openenergymonitor/emonTH/hardware/Datasheets/Evatron PP42M case drawing.jpg

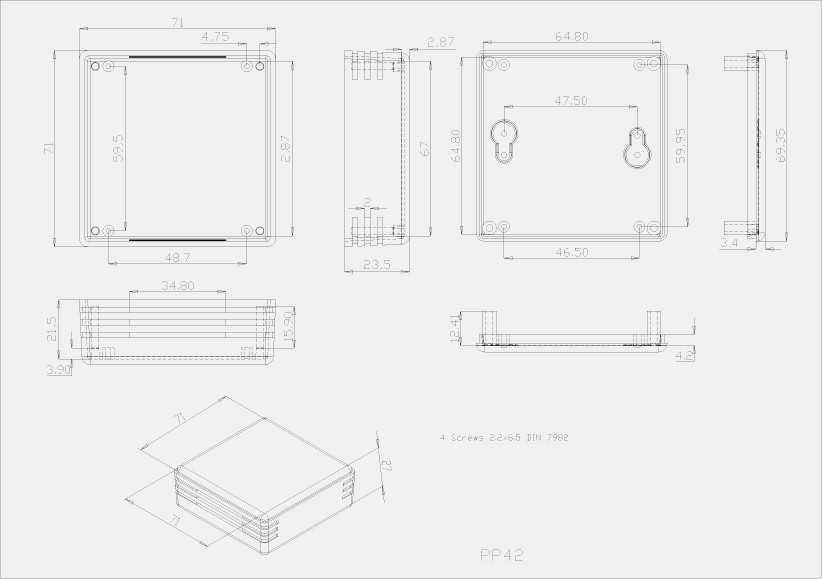
hardware/Datasheets/Evatron PP42M case drawing.jpg
