openenergymonitor/emonTH/hardware/emonTH_V1_4/emonTH V1.4.brd

## EAGLE design hardware/emonTH_V1_4/emonTH V1.4.brd (2017-03-15, an earlier design)

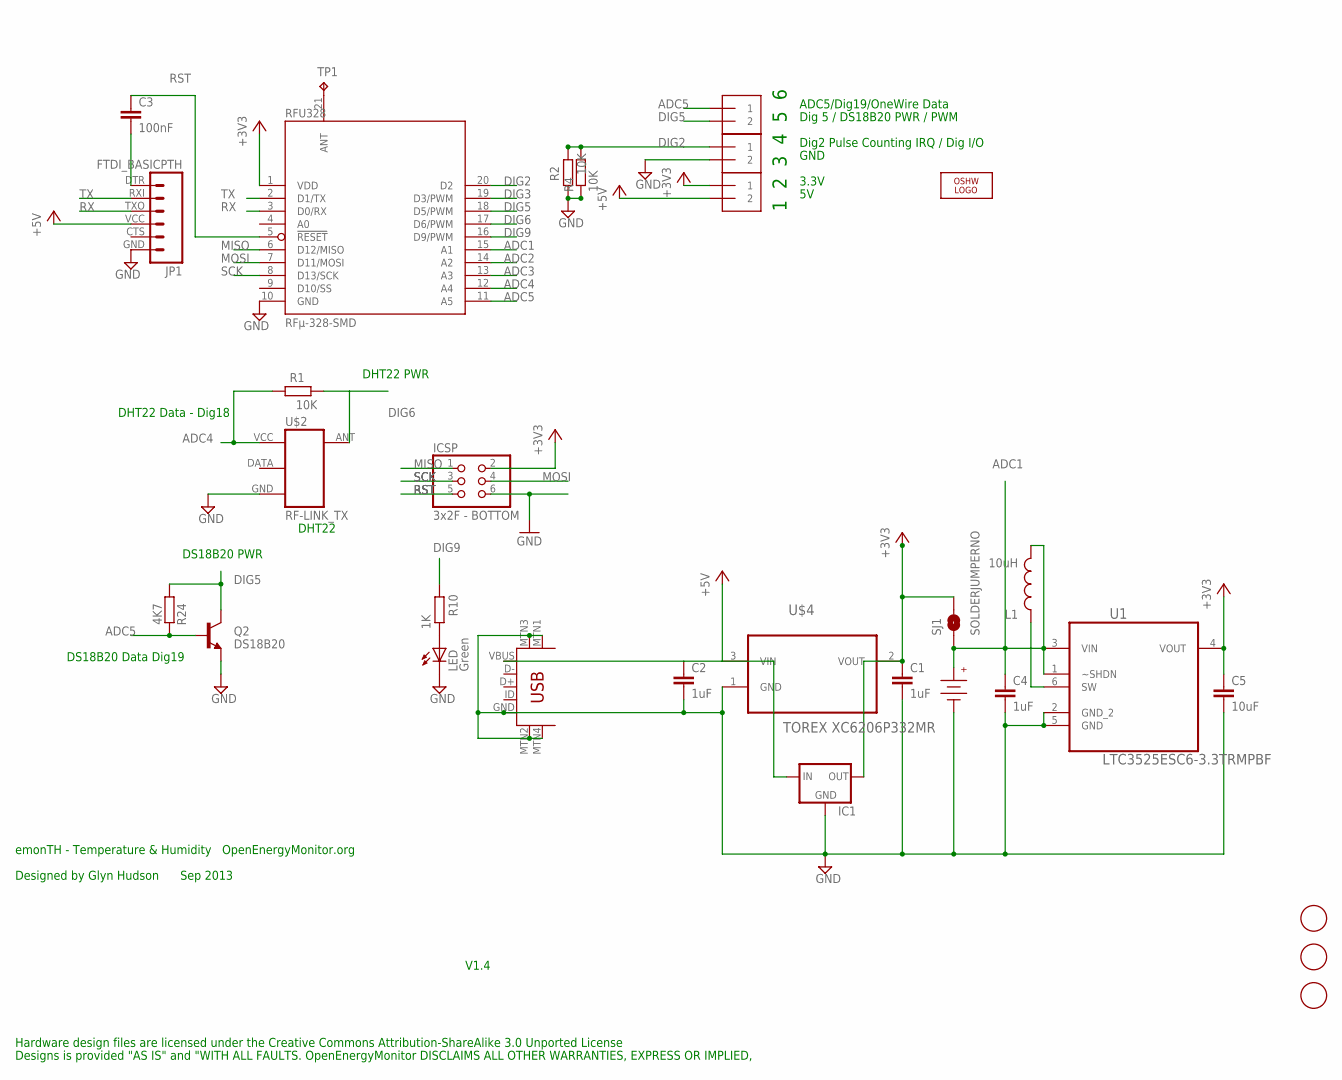
[picture p10: schematic emonTH V1.4.sch]

Parts:
C1, C2, C4: 1uF; C0603
C3: 100nF; C0603
C5: 10uF; C0603
IC1: 78XXS
ICSP: 3x2F - BOTTOM; 2X03
J1, J2, J3: 1X2-3.5MM
JP1: FTDI_BASICPTH; FTDI_BASIC
L1: 10uH; 1210
LED: Green; CHIP-LED0805
LOGO1: OSHW_LOGO_10MILX0200-NT; OSHW_10X200_NOTEXT
Q2: DS18B20; TO-92
R1, R2: 10K; R0603
R4: 10K; 0204/7
R10: 1K; R0603
R24: 4K7; R0603
RFU328: RFµ-328-SMD; RFµ-328-LANDING
SJ1: SOLDERJUMPERNO; SJ_2S-NO
TP1: TPPAD1-20; P1-20
U1: LTC3525ESC6-3.3TRMPBF; SOT65P210X100-6N
U$1, U$6, U$7: FIDUCIAL; FIDUCIAL_1MM
U$2: RF-LINK_TX
U$3: 3V; AAA_PCB_HOLDER
U$4: TOREX XC6206P332MR; SOT95P237X112-3N
U$5: USB-MINIB-5PIN; USB-MINIB-CISECO

Connections:
+3V3: C1.1, C5.1, IC1.OUT, ICSP.2, J3.1, RFU328.1 (VDD), SJ1.2, U1.4 (VOUT), U$4.2 (VOUT)
+5V: C2.1, IC1.IN, J3.2, JP1.VCC (4), U$4.3 (VIN), U$5.VBUS
ADC1: C4.1, L1.2, RFU328.15 (A1), SJ1.1, U1.1 (~SHDN), U1.3 (VIN), U$3.+
ADC2: RFU328.14 (A2)
ADC3: RFU328.13 (A3)
ADC4: R1.2, RFU328.12 (A4), U$2.VCC (+5V)
ADC5: J1.1, Q2.2 (B), R24.2, RFU328.11 (A5)
DIG2: J2.1, R2.1, R4.2, RFU328.20 (D2)
DIG3: RFU328.19 (D3/PWM)
DIG5: J1.2, Q2.3 (C), R24.1, RFU328.18 (D5/PWM)
DIG6: R1.1, RFU328.17 (D6/PWM), U$2.ANT
DIG9: R10.2, RFU328.16 (D9/PWM)
GND: C1.2, C2.2, C4.2, C5.2, IC1.GND, ICSP.6, J2.2, JP1.GND (6), LED.C, Q2.1 (E), R2.2, R4.1, RFU328.10 (GND), U1.2 (GND_2), U1.5 (GND), U$2.GND, U$3.-, U$4.1 (GND), U$5.GND, U$5.MTN1 (MTN2), U$5.MTN2 (MTN3), U$5.MTN3 (MTN1), U$5.MTN4
MISO: ICSP.1, RFU328.6 (D12/MISO)
MOSI: ICSP.4, RFU328.7 (D11/MOSI)
unnamed: RFU328.21 (ANT), TP1.TP
unnamed: C3.2, JP1.DTR (1)
unnamed: L1.1, U1.6 (SW)
unnamed: LED.A, R10.1
RST: C3.1, ICSP.5, RFU328.5 (!RESET)
RX: JP1.TXO (3), RFU328.3 (D0/RX)
SCK: ICSP.3, RFU328.8 (D13/SCK)
TX: JP1.RXI (2), RFU328.2 (D1/TX)

Notes on the sheet:
emonTH - Temperature & Humidity OpenEnergyMonitor.org
Designed by Glyn Hudson Sep 2013
V1.4
DS18B20 PWR
DS18B20 Data Dig19
ADC5/Dig19/OneWire Data
Dig 5 / DS18B20 PWR / PWM
Dig2 Pulse Counting IRQ / Dig I/O
GND
3.3V
DHT22 PWR
DHT22
1 2 3 4 5 6
DHT22 Data - Dig18
Hardware design files are licensed under the Creative Commons Attribution-ShareAlike 3.0 Unported License
Designs is provided "AS IS" and "WITH ALL FAULTS. OpenEnergyMonitor DISCLAIMS ALL OTHER WARRANTIES, EXPRESS OR IMPLIED,

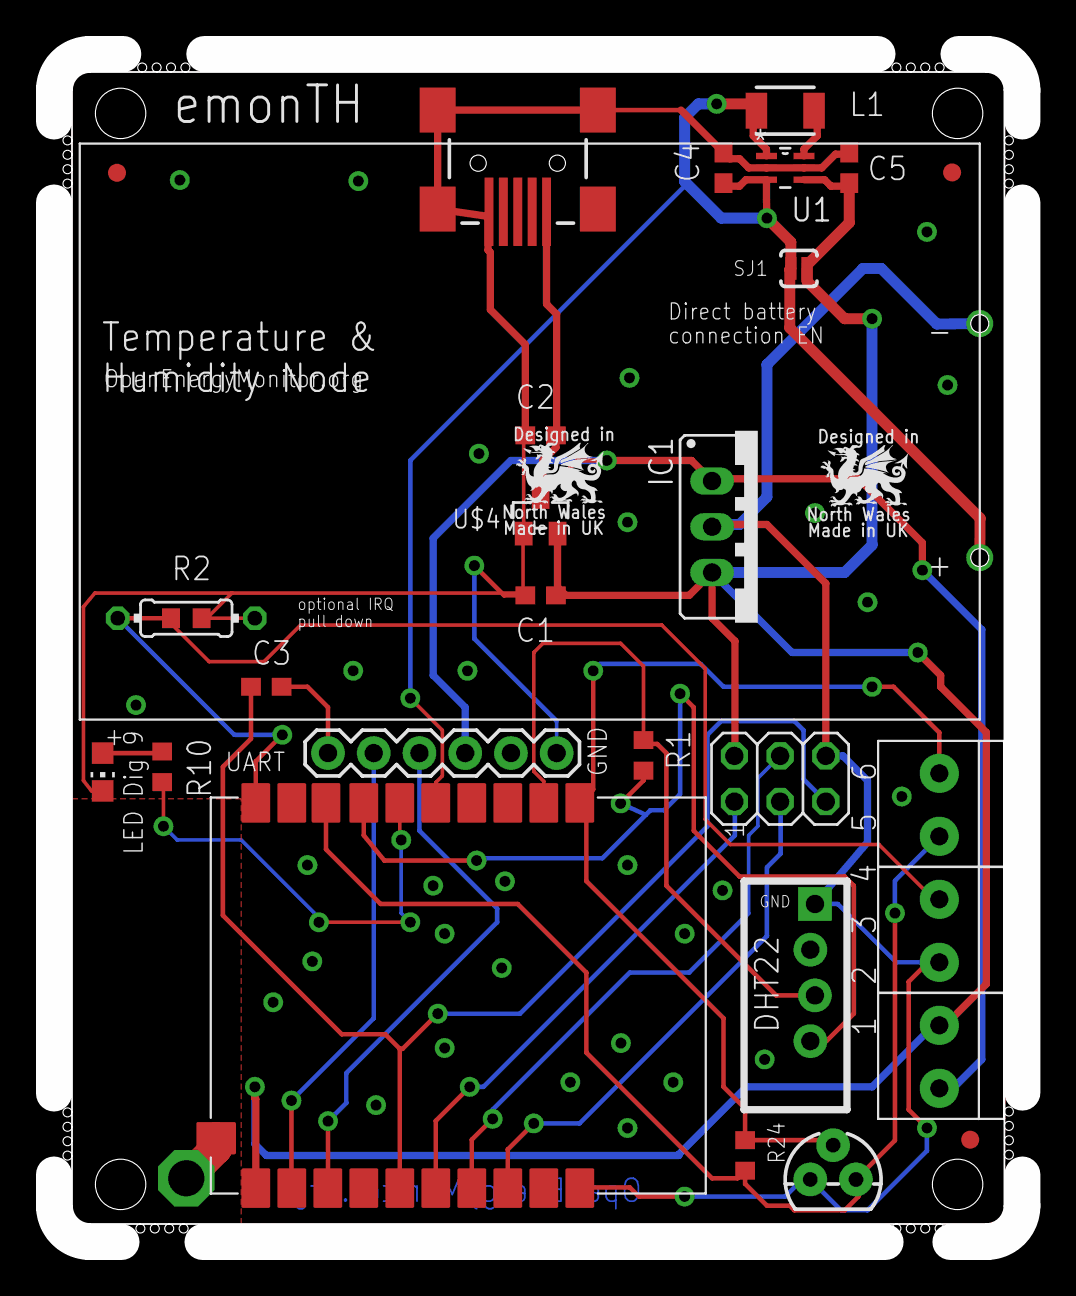
[picture p11: board emonTH V1.4.brd from above]

Board: 2 copper layers, 53.8 x 66.0 mm, 31 parts (1 on the bottom side), 20 nets.
