openenergymonitor/emonTH/hardware/emonTH_V1_5/emonTH V1.5.2.brd

## EAGLE design hardware/emonTH_V1_5/emonTH V1.5.2.brd (2017-03-15)

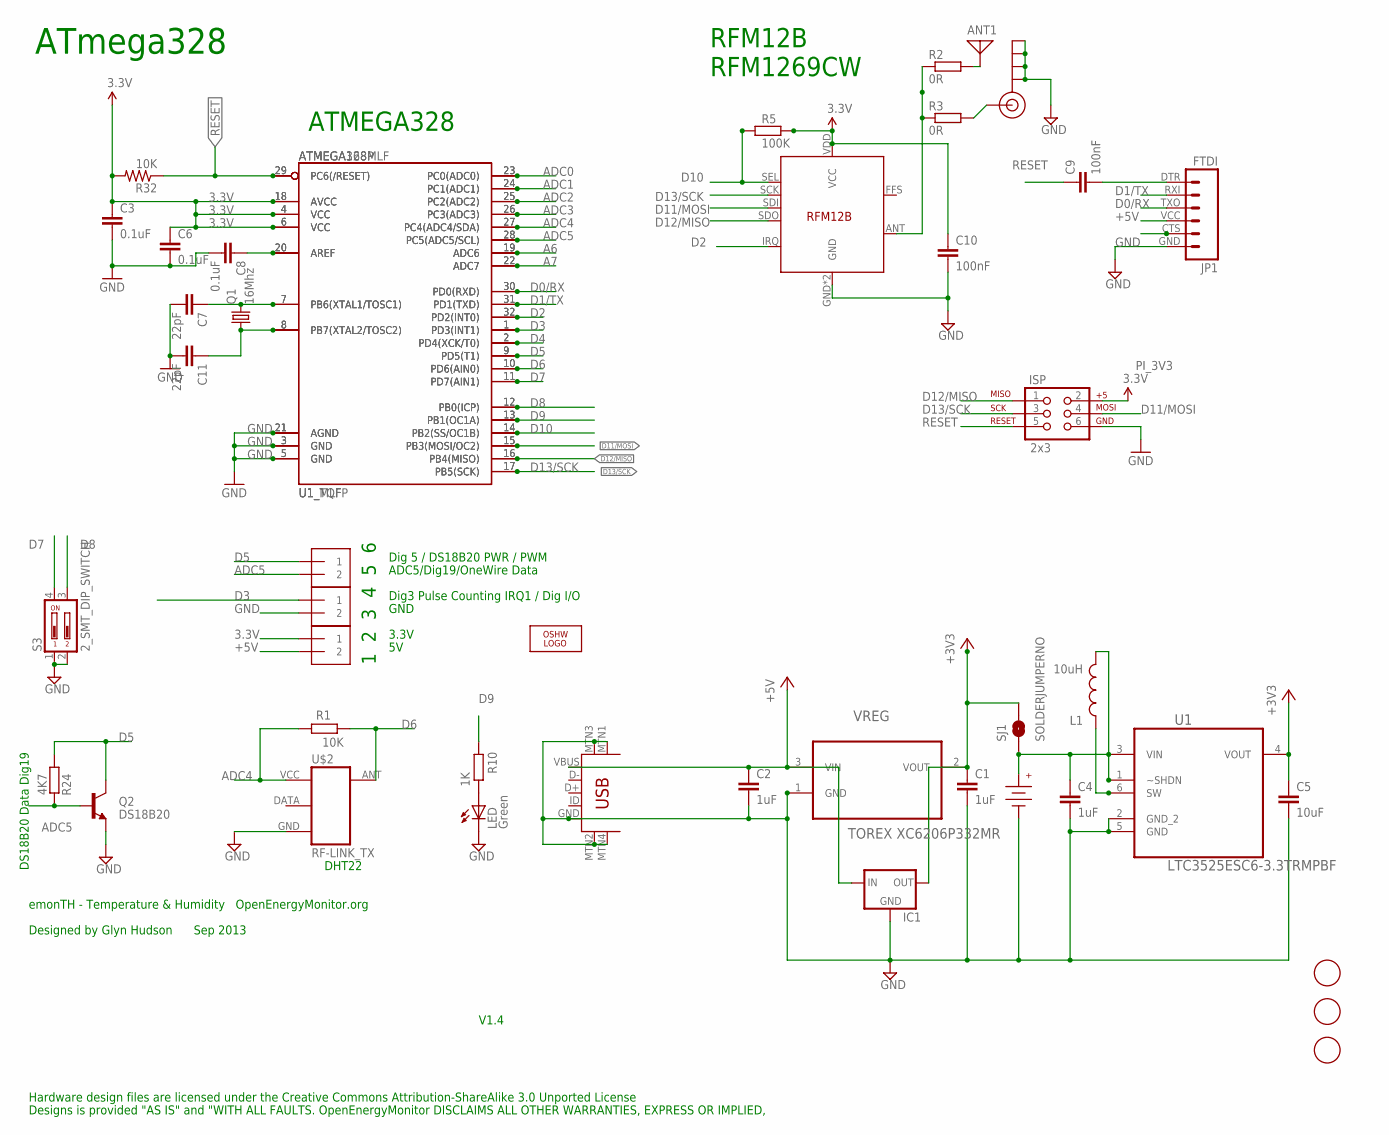
[picture p12: schematic emonTH V1.5.2.sch]

Parts:
ANT1: ANTENNA; PAD-01
C1, C2, C4: 1uF; C0603
C3, C6, C8: 0.1uF; C0603
C5: 10uF; C0603
C7, C11: 22pF; C0603
C9, C10: 100nF; C0603
IC1: 78XXS
ISP: 2x3; 2X3
J1, J2, J3: 1X2-3.5MM
J$1: SMA_EDGE; SMA-EDGE
JP1: FTDI; FTDI_BASIC
L1: 10uH; 1210
LED: Green; CHIP-LED0805
LOGO2: OSHW_LOGO_10MILX0200-NT; OSHW_10X200_NOTEXT
Q1: 16Mhz; HC49UP
Q2: DS18B20; TO-92
R1, R32: 10K; R0603
R2, R3: 0R; R0603
R5: 100K; R0603
R10: 1K; R0603
R24: 4K7; R0603
S3: 2_SMT_DIP_SWITCH; DIP_SWITCH_SMT
SJ1: SOLDERJUMPERNO; SJ_2S-NO
U1: LTC3525ESC6-3.3TRMPBF; SOT65P210X100-6N
U1_MLF: ATMEGA168MLF; MLF32
U1_TQFP: ATMEGA328P; TQFP32-08
U$1, U$6, U$7: FIDUCIAL; FIDUCIAL_1MM
U$2: RF-LINK_TX
U$3: 3V; AAA_PCB_HOLDER
U$5: USB-MINIB-5PIN; USB-MINIB-CISECO
U$14: RFM12B
VREG: TOREX XC6206P332MR; SOT95P237X112-3N

Connections:
3.3V: C1.1, C3.1, C5.1, C6.1, C10.1, IC1.OUT, ISP.2, J3.1, R5.2, R32.2, SJ1.2, U1.4 (VOUT), U1_MLF.4 (VCC), U1_MLF.6 (VCC), U1_MLF.18 (AVCC), U1_TQFP.4 (VCC), U1_TQFP.6 (VCC), U1_TQFP.18 (AVCC), U$14.VDD (VCC), VREG.2 (VOUT)
+5V: C2.1, IC1.IN, J3.2, JP1.VCC (4), U$5.VBUS, VREG.3 (VIN)
A6: U1_MLF.19 (ADC6), U1_TQFP.19 (ADC6)
A7: U1_MLF.22 (ADC7), U1_TQFP.22 (ADC7)
ADC0: U1_MLF.23 (PC0(ADC0)), U1_TQFP.23 (PC0(ADC0))
ADC1: C4.1, L1.2, SJ1.1, U1.1 (~SHDN), U1.3 (VIN), U1_MLF.24 (PC1(ADC1)), U1_TQFP.24 (PC1(ADC1)), U$3.+
ADC2: U1_MLF.25 (PC2(ADC2)), U1_TQFP.25 (PC2(ADC2))
ADC3: U1_MLF.26 (PC3(ADC3)), U1_TQFP.26 (PC3(ADC3))
ADC4: R1.2, U1_MLF.27 (PC4(ADC4/SDA)), U1_TQFP.27 (PC4(ADC4/SDA)), U$2.VCC (+5V)
ADC5: J1.2, Q2.2 (B), R24.2, U1_MLF.28 (PC5(ADC5/SCL)), U1_TQFP.28 (PC5(ADC5/SCL))
D0/RX: JP1.TXO (3), U1_MLF.30 (PD0(RXD)), U1_TQFP.30 (PD0(RXD))
D1/TX: JP1.RXI (2), U1_MLF.31 (PD1(TXD)), U1_TQFP.31 (PD1(TXD))
D2: U1_MLF.32 (PD2(INT0)), U1_TQFP.32 (PD2(INT0)), U$14.IRQ
D3: J2.1, U1_MLF.1 (PD3(INT1)), U1_TQFP.1 (PD3(INT1))
D4: U1_MLF.2 (PD4(XCK/T0)), U1_TQFP.2 (PD4(XCK/T0))
D5: J1.1, Q2.3 (C), R24.1, U1_MLF.9 (PD5(T1)), U1_TQFP.9 (PD5(T1))
D6: R1.1, U1_MLF.10 (PD6(AIN0)), U1_TQFP.10 (PD6(AIN0)), U$2.ANT
D7: S3.4, U1_MLF.11 (PD7(AIN1)), U1_TQFP.11 (PD7(AIN1))
D8: S3.3, U1_MLF.12 (PB0(ICP)), U1_TQFP.12 (PB0(ICP))
D9: R10.2, U1_MLF.13 (PB1(OC1A)), U1_TQFP.13 (PB1(OC1A))
D10: R5.1, U1_MLF.14 (PB2(SS/OC1B)), U1_TQFP.14 (PB2(SS/OC1B)), U$14.SEL
D11/MOSI: ISP.4, U1_MLF.15 (PB3(MOSI/OC2)), U1_TQFP.15 (PB3(MOSI/OC2)), U$14.SDI
D12/MISO: ISP.1, U1_MLF.16 (PB4(MISO)), U1_TQFP.16 (PB4(MISO)), U$14.SDO
D13/SCK: ISP.3, U1_MLF.17 (PB5(SCK)), U1_TQFP.17 (PB5(SCK)), U$14.SCK
DIG1: R2.1, R3.1, U$14.ANT
GND: C1.2, C2.2, C3.2, C4.2, C5.2, C6.2, C7.2, C8.2, C10.2, C11.2, IC1.GND, ISP.6, J2.2, J$1.GND@0 (GND), J$1.GND@1 (GND), J$1.GND@2 (GND), J$1.GND@3 (GND), JP1.GND (6), LED.C, Q2.1 (E), S3.1, S3.2, U1.2 (GND_2), U1.5 (GND), U1_MLF.3 (GND), U1_MLF.5 (GND), U1_MLF.21 (AGND), U1_TQFP.3 (GND), U1_TQFP.5 (GND), U1_TQFP.21 (AGND), U$2.GND, U$3.-, U$5.GND, U$5.MTN1 (MTN2), U$5.MTN2 (MTN3), U$5.MTN3 (MTN1), U$5.MTN4, U$14.GND, U$14.P$12 (GND), VREG.1 (GND)
unnamed: C7.1, Q1.2, U1_MLF.7 (PB6(XTAL1/TOSC1)), U1_TQFP.7 (PB6(XTAL1/TOSC1))
unnamed: L1.1, U1.6 (SW)
unnamed: C11.1, Q1.1, U1_MLF.8 (PB7(XTAL2/TOSC2)), U1_TQFP.8 (PB7(XTAL2/TOSC2))
unnamed: ANT1.1, R2.2
unnamed: C8.1, U1_MLF.20 (AREF), U1_TQFP.20 (AREF)
unnamed: C9.2, JP1.DTR (1)
unnamed: J$1.SIG (SIGNAL), R3.2
unnamed: LED.A, R10.1
RESET: C9.1, ISP.5, R32.1, U1_MLF.29 (PC6(/RESET)), U1_TQFP.29 (PC6(/RESET))

Notes on the sheet:
emonTH - Temperature & Humidity OpenEnergyMonitor.org
Designed by Glyn Hudson Sep 2013
V1.4
DS18B20 Data Dig19
ADC5/Dig19/OneWire Data
Dig 5 / DS18B20 PWR / PWM
Dig3 Pulse Counting IRQ1 / Dig I/O
GND
3.3V
DHT22
1 2 3 4 5 6
Hardware design files are licensed under the Creative Commons Attribution-ShareAlike 3.0 Unported License
Designs is provided "AS IS" and "WITH ALL FAULTS. OpenEnergyMonitor DISCLAIMS ALL OTHER WARRANTIES, EXPRESS OR IMPLIED,
ATmega328
ATMEGA328
RFM12B RFM1269CW

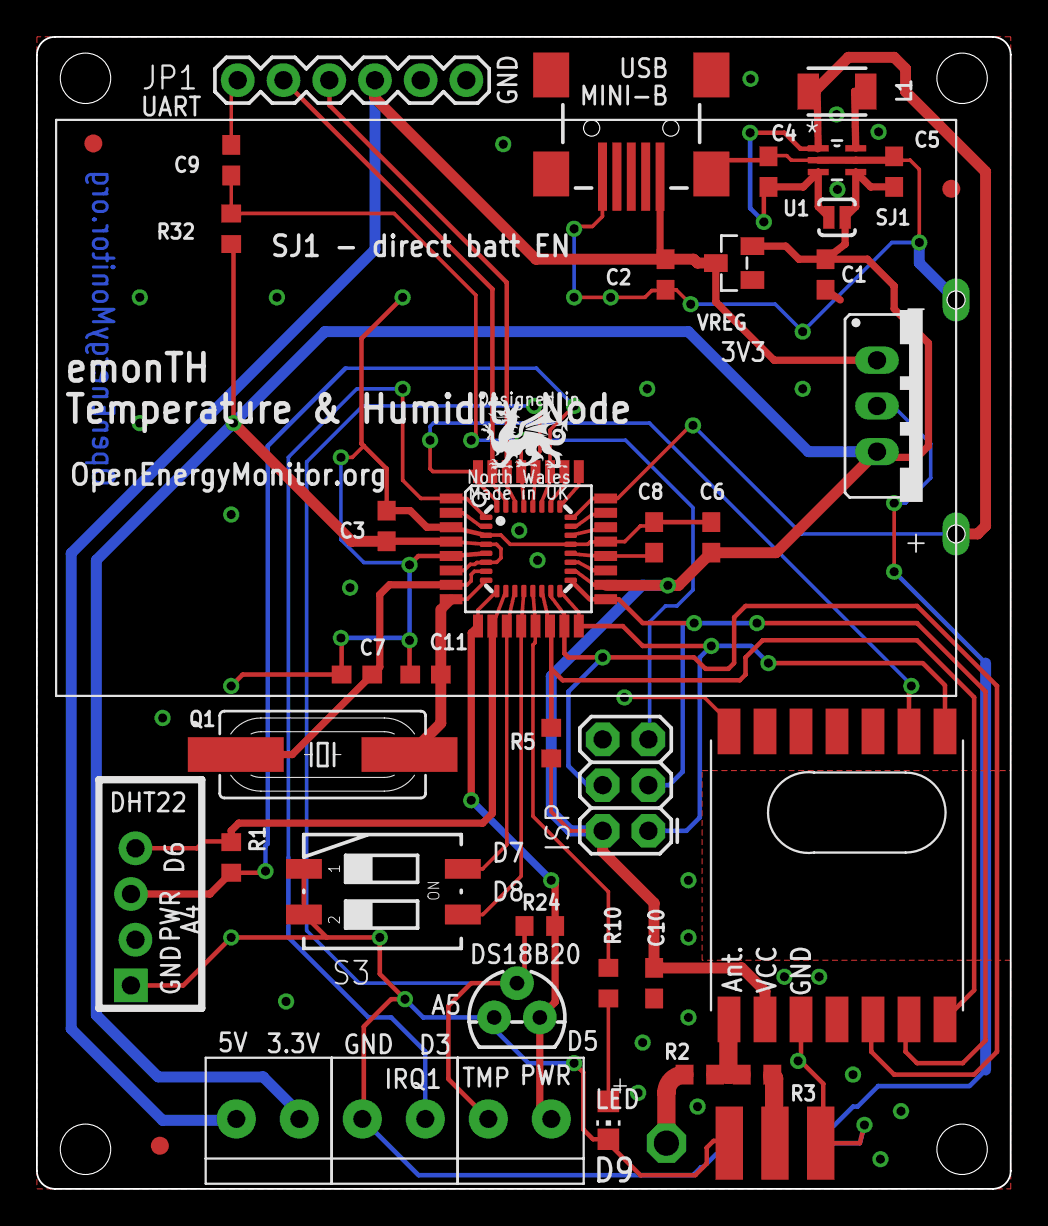
[picture p13: board emonTH V1.5.2.brd from above]

Board: 2 copper layers, 54.1 x 64.0 mm, 44 parts (1 on the bottom side), 35 nets.
