openenergymonitor/emonTH/(commit log)

2013-10-16 power saving tweaks
2013-11-07 fix battery voltage reading
2013-11-13 add RFM12B test sequence and 'no sensor detected' notification
2013-11-21 add support for external DS18B20 temp sensor
2013-11-25 Indentation clean up and description to debug print out
2014-01-05 remove power_adc_disable call http://openenergymonitor.blogspot.co.uk/2013/10/emonth-update-software-power.html?showComment=1387722240596
2014-01-18 add temperature hardware address discovery sketch
2014-01-23 Some corrections - was hanging on retry after power down (oops)
    [emonTH_gas_reflection_analogue.ino]
2014-02-26 remove serial debug by default - increase battery life
2014-02-26 add non-debug version to save battery life, serial o/p disabled
2014-03-22 fix bug which caused emonTH to hang on connection of external sensor when debug was active, change factory test RF packet tx to count down to zero from 10 intead of up. No debug is now the default
2014-04-17 changed update interval from mins to secs
    Changed update interval from minutes to seconds for more user control. -
    Allow intervals of 15-30 seconds for fast changing temperatures.
2014-04-18 Created new program for multiple sensor onewire bus discovery
    new program added for dynamic scanning of onewire bus and automatic
    detection of up to 20 sensors (easily changeable) arduino program is
    well on it's way to working but still has some bugs and incomplete bits.
2014-04-18 added documentation
    added documentation about new multiple onewire sensor program to the
    readme file.
2014-04-19 semi working - sensors read out, but bad radio
    Quashed compile bug and redid some documentation, but radio does not
    transmit proper values - it probably can't handle the array in the
    typedef struct. will have to fix that. the sensors scan fine and write
    correctly to the array (varified by serial output) - also, the power
    saving delay has the ability to corrupt serial transmissions. changing
    these to regular delays fixes this. - getting there!
2014-04-19 added defined array size and cleaned up some code
    Defined the array size with max number of sensors and cleaned up power
    saving delay code. Also improved documentation throughout the program.
2014-04-22 Fixed a continuing typo
    Fixed a continuing typo that limits the amount of sensors to 70 instead
    of 60.
2014-04-24 Formatting for merge
    comments formatted for easier reading and readme file updated. program
    function not affected and has been running fine since the last commit
    through several power cycles. I would call it stable
2014-11-23 Fix typo: sensor
2015-01-05 code cleanup, fixed sleep timer for minutes delay
    [emonTH_DHT22_dual_DS18B20.ino]
2015-03-22 Increase async delay for multiple sensors
    http://openenergymonitor.org/emon/node/10206
2015-05-11 emonTH v1.5.1 RF node ID DIP switch bug fix
2015-08-05 20ms delay in emonth rfm69 sketch plus new emonth low power pulse counter example
2015-08-13 update firmware version in serial print to V1.6.1
2015-09-02 Pulse counting + DHT22 + DS18B20 example for emonth Low power pulse counting only
2015-10-03 v0.2 of emonTH_DHT22_DS18B20_RFM69CW_Pulse uses timer1 for 60s rf transmit period + decouples rf transmit from pulse interrupt event
2015-10-03 Low power pulse counting example + dht22 and ds18b20 temperature sensing based on low power pulse counting example by Erin Amann http://openenergymonitor.org/emon/node/10834
2015-10-06 EmonTH low power pulse counting example by Eric AMANN replacing the not so low power example that was before
2015-10-12 don't flash LED on RF transmission to save power
2015-10-15 V2.4 activate pulse count pin input pullup to stop spurious pulses when no sensor connected
2015-11-10 fix incorrect emonTH pins
    [emonTH_DHT22_DS18B20_RFM69CW_Pulse.ino]
2016-03-04 add low power reed switch example for emonTx V1.5
2016-07-26 add htu21 sensor test example
2016-07-26 add sensor readme
2016-07-26 update temperature accuracy
2016-08-05 add bme280 sensor example
2016-08-15 add si7021 sensor test
2016-08-31 Added example how to increase better battery measurement accuracy
2016-09-02 Replace variable used for testing with actual value of BATT_ADC pin
    [emonTH_DHT22_DS18B20_RFM69CW_Pulse.ino]
2017-03-15 add emonTH 1.x hardware!
    [emonTH V1.4.brd, emonTH V1.4.sch, emonTH V1.5.2.brd, emonTH V1.5.2.sch]
